vectorcrumb/Ballbot_IEE2913/README.md

# IEE2913
Codigo, esquematicos y planos para proyecto Ballbot para el ramo IEE2913, Diseño Electrico, semestre 2019-2
