vectorcrumb/Ballbot_IEE2913/cad/electrical/Motherboard.brd

## EAGLE design cad/electrical/Motherboard.brd (2019-10-10)

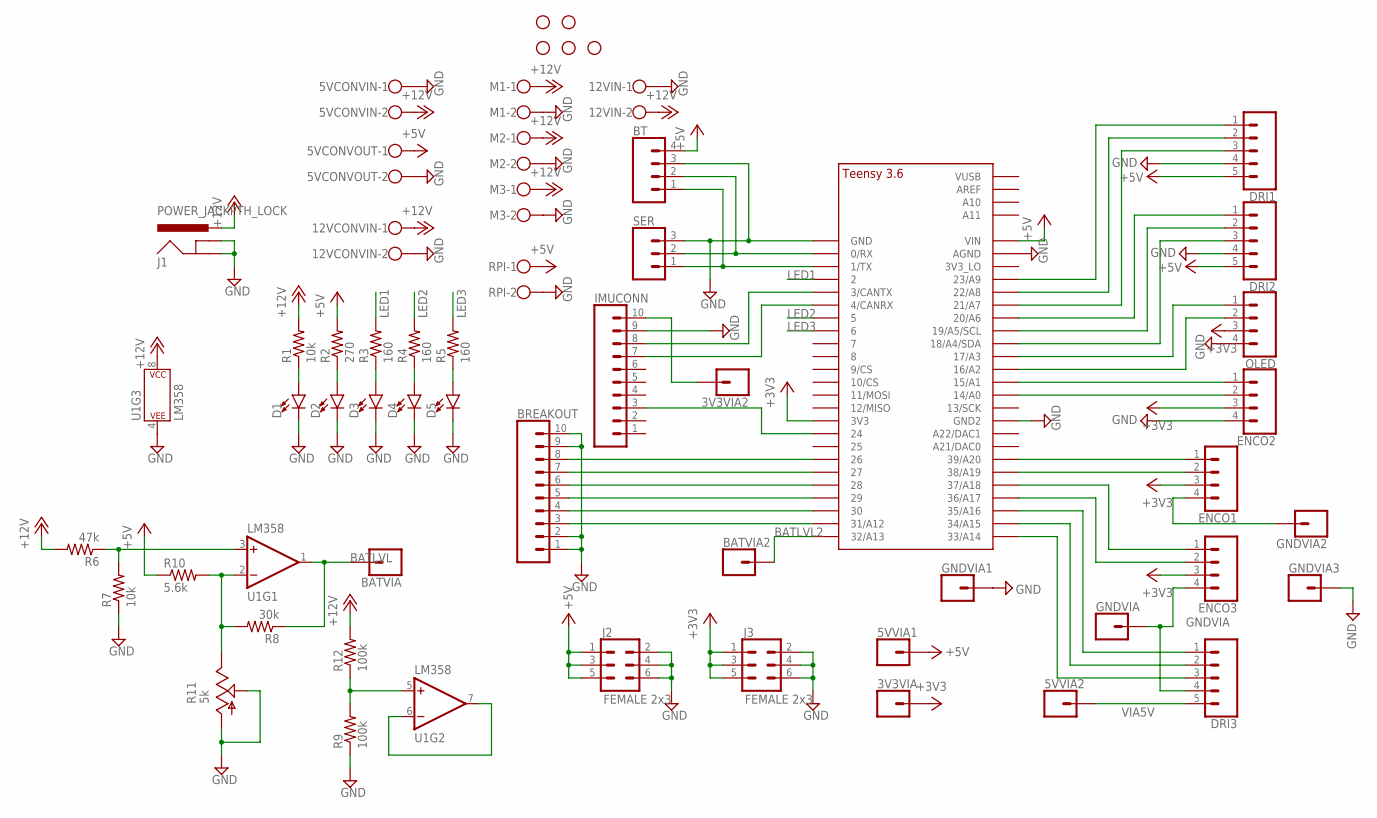
[picture p1: schematic Motherboard.sch]

Parts:
3V3VIA, 3V3VIA2, 5VVIA1, 5VVIA2: CONN_01; 1X01
5VCONVIN, 5VCONVOUT, 12VCONVIN, 12VIN: W237-102
BATVIA, BATVIA2: CONN_01; 1X01
BREAKOUT: CONN_10LOCK; 1X10_LOCK
BT: CONN_04LOCK; 1X04_LOCK
D1, D2, D3, D4, D5: LED5MM-KIT; LED_5MM-KIT
DRI1, DRI2, DRI3: CONN_05LOCK; 1X05_LOCK
ENCO1, ENCO2, ENCO3: CONN_04LOCK; 1X04_LOCK
GNDVIA, GNDVIA1, GNDVIA2, GNDVIA3: CONN_01; 1X01
H1, H2, H4, H5, H6: STAND-OFF
IMUCONN: CONN_10LOCK; 1X10_LOCK
J1: POWER_JACKPTH_LOCK; POWER_JACK_PTH_LOCK
J2, J3: FEMALE 2x3; 2X3
M1, M2, M3: W237-102
OLED: CONN_04LOCK; 1X04_LOCK
R1, R7: 10k; 0207/10
R2: 270; 0207/10
R3, R4, R5: 160; 0207/10
R6: 47k; 0207/10
R8: 30k; 0207/10
R9, R12: 100k; 0207/10
R10: 5.6k; 0207/10
R11: 5k; B25P
RPI: W237-102
SER: CONN_03LOCK; 1X03_LOCK
U1: LM358; DIP08
U$1: TEENSY_3.5/3.6_BASIC

Connections:
+3V3: 3V3VIA.1, ENCO1.3, ENCO2.3, ENCO3.3, J3.1, J3.3, J3.5, OLED.3, U$1.3V3
+5V: 5VCONVOUT.1, 5VVIA1.1, BT.4, DRI1.5, DRI2.5, J2.1, J2.3, J2.5, R2.2, R10.1, RPI.1, U$1.VIN
+12V: 5VCONVIN.2, 12VCONVIN.1, 12VIN.2, J1.PWR, M1.1, M2.1, M3.1, R1.2, R6.2, R12.2, U1.8 (P$V+)
BATLVL: BATVIA.1, R8.1, U1.1 (OUT)
BATLVL2: BATVIA2.1, U$1.32/A13
GND: 5VCONVIN.1, 5VCONVOUT.2, 12VCONVIN.2, 12VIN.1, BREAKOUT.1, BREAKOUT.2, BREAKOUT.9, BREAKOUT.10, BT.3, D1.K (C), D2.K (C), D3.K (C), D4.K (C), D5.K (C), DRI1.4, DRI2.4, ENCO2.4, GNDVIA1.1, GNDVIA3.1, IMUCONN.9, J1.GND, J1.GNDBREAK, J2.2, J2.4, J2.6, J3.2, J3.4, J3.6, M1.2, M2.2, M3.2, OLED.4, R7.1, R9.1, R11.A, R11.S, RPI.2, SER.3, U1.4 (P$V-), U$1.AGND, U$1.GND, U$1.GND2
GNDVIA: DRI3.4, ENCO3.4, GNDVIA.1
LED1: R3.2, U$1.2
LED2: R4.2, U$1.5
LED3: R5.2, U$1.6
unnamed: DRI1.1, U$1.23/A9
unnamed: DRI1.2, U$1.22/A8
unnamed: DRI1.3, U$1.21/A7
unnamed: DRI2.3, U$1.18/A4/SDA
unnamed: DRI2.2, U$1.19/A5/SCL
unnamed: DRI2.1, U$1.20/A6
unnamed: ENCO2.1, U$1.15/A1
unnamed: ENCO2.2, U$1.14/A0
unnamed: ENCO1.1, U$1.39/A20
unnamed: ENCO1.2, U$1.38/A19
unnamed: ENCO3.1, U$1.37/A18
unnamed: ENCO3.2, U$1.36/A17
unnamed: DRI3.1, U$1.35/A16
unnamed: DRI3.2, U$1.34/A15
unnamed: DRI3.3, U$1.33/A14
unnamed: BT.1, SER.1, U$1.1/TX
unnamed: BT.2, SER.2, U$1.0/RX
unnamed: IMUCONN.8, U$1.3/CANTX
unnamed: IMUCONN.7, U$1.4/CANRX
unnamed: IMUCONN.3, U$1.24
unnamed: R9.2, R12.1, U1.5 (+IN)
unnamed: BREAKOUT.3, U$1.31/A12
unnamed: BREAKOUT.4, U$1.30
unnamed: BREAKOUT.5, U$1.29
unnamed: BREAKOUT.6, U$1.28
unnamed: BREAKOUT.7, U$1.27
unnamed: BREAKOUT.8, U$1.26
unnamed: D2.A, R2.1
unnamed: D1.A, R1.1
unnamed: D3.A, R3.1
unnamed: D5.A, R5.1
unnamed: D4.A, R4.1
unnamed: 3V3VIA2.1, IMUCONN.10
unnamed: OLED.1, U$1.17/A3
unnamed: OLED.2, U$1.16/A2
unnamed: R6.1, R7.2, U1.3 (+IN)
unnamed: U1.6 (-IN), U1.7 (OUT)
unnamed: R8.2, R10.2, R11.E, U1.2 (-IN)
unnamed: ENCO1.4, GNDVIA2.1
VIA5V: 5VVIA2.1, DRI3.5

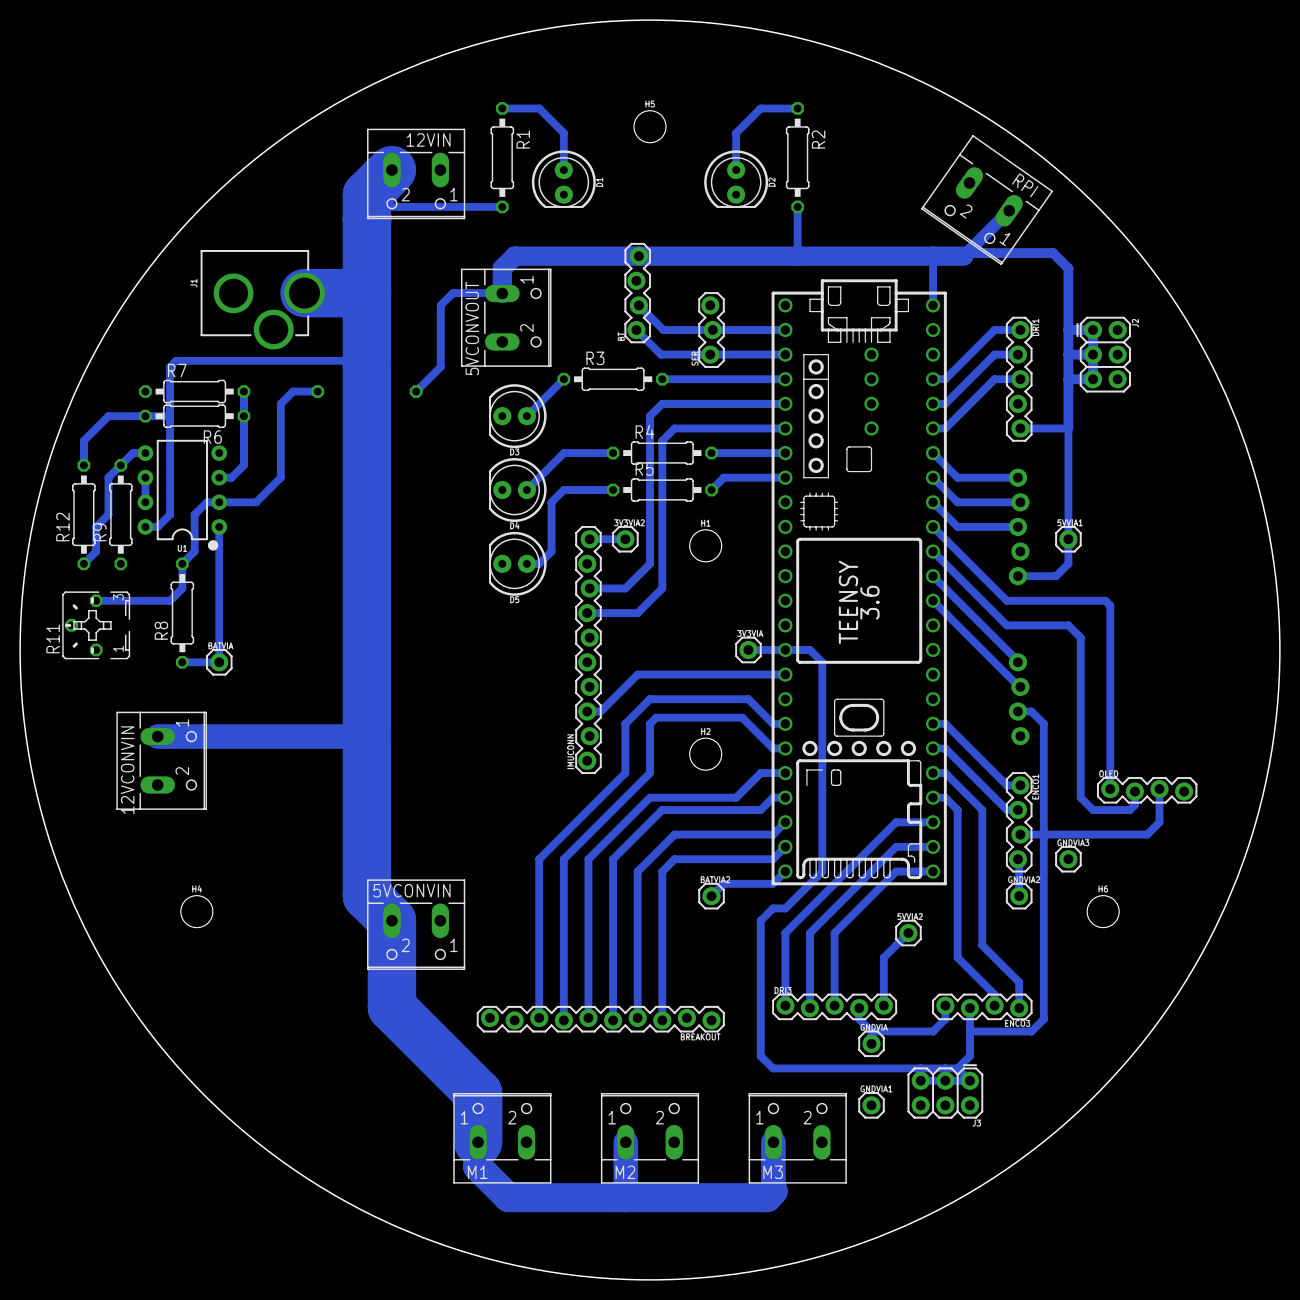
[picture p2: board Motherboard.brd from above]

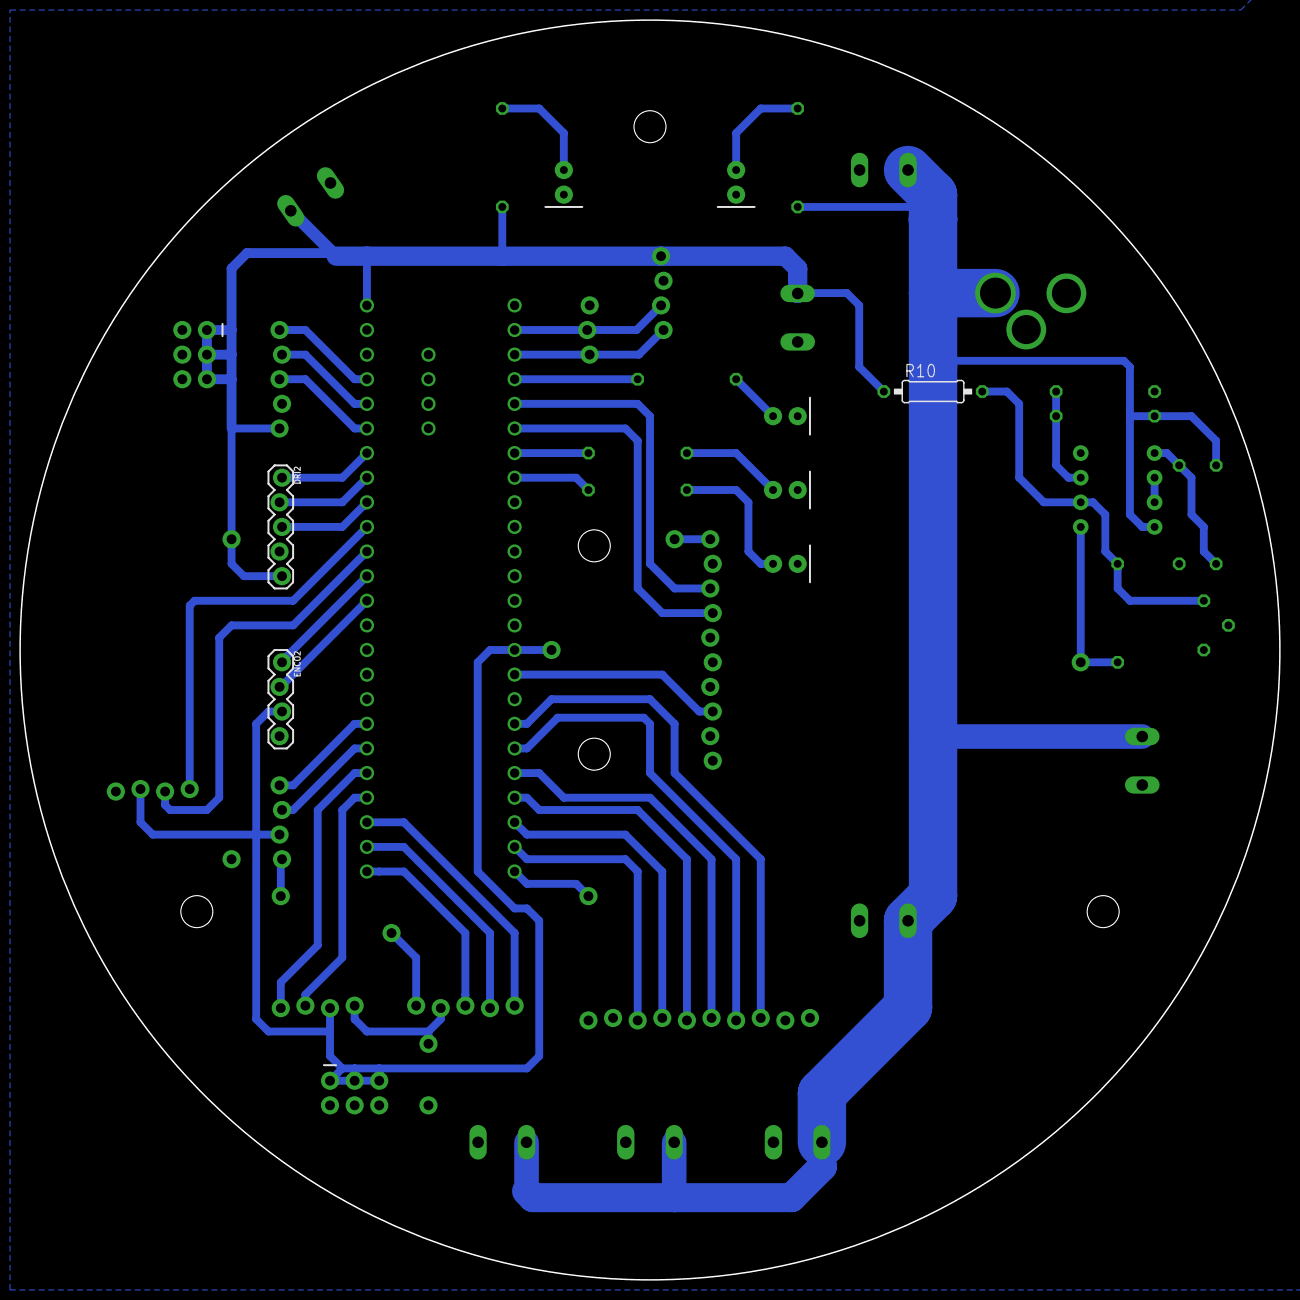
[picture p3: board Motherboard.brd from below]

Board: 2 copper layers, 130.0 x 130.0 mm, 56 parts (3 on the bottom side), 50 nets.
