vectorcrumb/Ballbot_IEE2913/cad/electrical/USB_Adapter/USBAdap.brd

## EAGLE design cad/electrical/USB_Adapter/USBAdap.brd (2019-10-10)

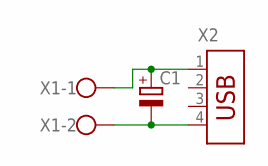
[picture p4: schematic USBAdap.sch]

Parts:
C1: CPOL-EUE5-8.5; E5-8,5
X1: W237-102
X2: USB-787616; USB

Connections:
unnamed: C1.+, X1.1, X2.1
unnamed: C1.-, X1.2, X2.4

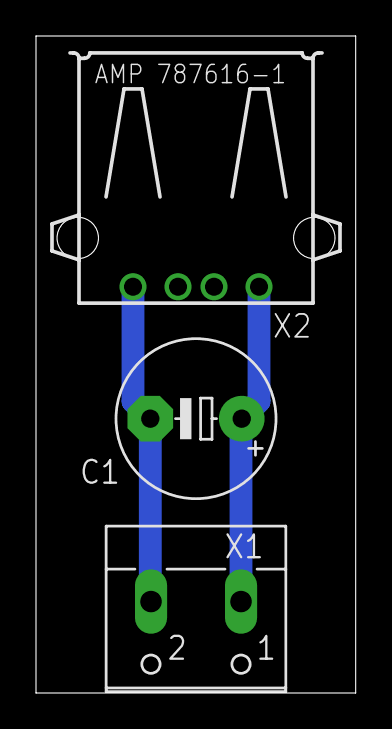
[picture p5: board USBAdap.brd from above]

Board: 2 copper layers, 17.8 x 36.5 mm, 3 parts (0 on the bottom side), 2 nets.
