vectorcrumb/Ballbot_IEE2913/(commit log)

2019-10-09 Added robot basic code and electrical CAD
    [Motherboard.brd, Motherboard.dxf, Motherboard.sch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]
2019-10-10 Imported robot code and electrical CAD
    [Motherboard.brd, Motherboard.dxf, Motherboard.sch, USBAdap.brd, USBAdap.sch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]
2019-10-11 Implemented MPU9250 w/Madgwick filter and OLED.
2019-10-13 COdigo motores
2019-11-07 Complete robot code refactoring. Added TeensyDelay library. Still have to fix errors for TorqueMotor class.
    [control.cpp, control.h, dataStructs.h, main.cpp, state.cpp, state.h, transforms.cpp, transforms.h]
2019-11-14 Added torque control motor.
2019-11-15 Fixed startup errors for rewrite.
    [main.cpp]
2019-11-15 Fixing motor PID issues.
    [main.cpp]
2019-11-15 Continued debugging. Found error in sensor reading
    [control.cpp, control.h, main.cpp, state.cpp, state.h, transforms.cpp, transforms.h]
